Yiluo-pHoton/Electrick_ROV/README.md

# Electrick_ROV
Remotely Opearted Vehicle with Visualized Terrain

This is a quarter-long project for PHYS CS 15C at UCSB. Collaborators include David Wang, Frank Fu, and Yiluo Li.
