Yiluo-pHoton/Electrick_ROV/Final_paper/figure/EIT.png

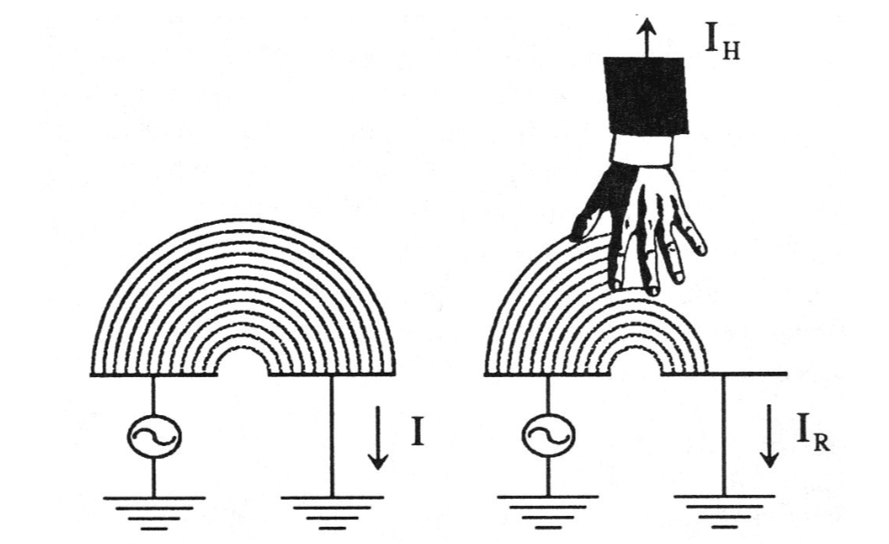
Final_paper/figure/EIT.png
