Yiluo-pHoton/Electrick_ROV/Final_paper/figure/finger1.JPG

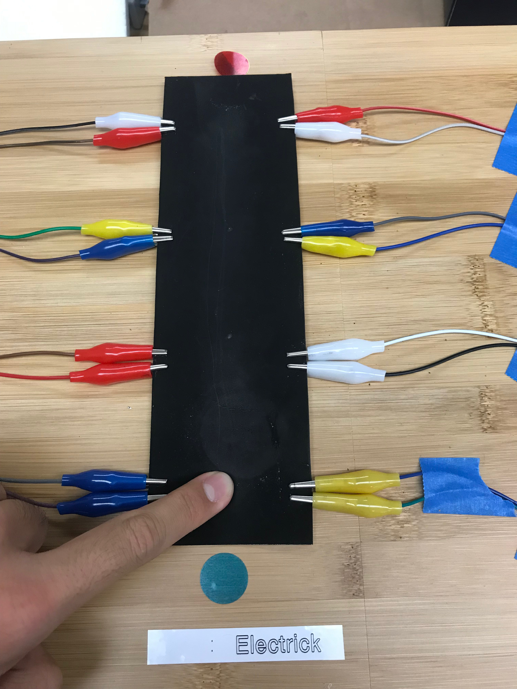
Final_paper/figure/finger1.JPG
