Yiluo-pHoton/Electrick_ROV/Final_paper/figure/finger2.JPG

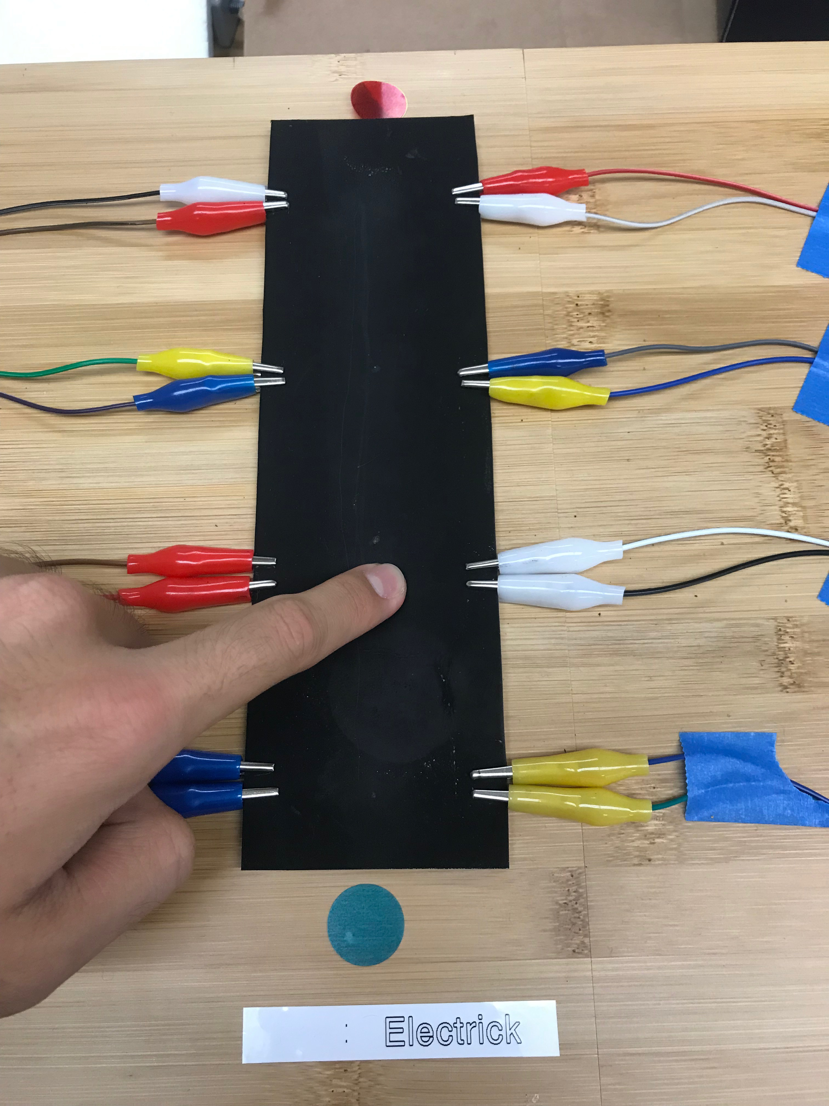
Final_paper/figure/finger2.JPG
