Yiluo-pHoton/Electrick_ROV/Final_paper/figure/finger3.JPG

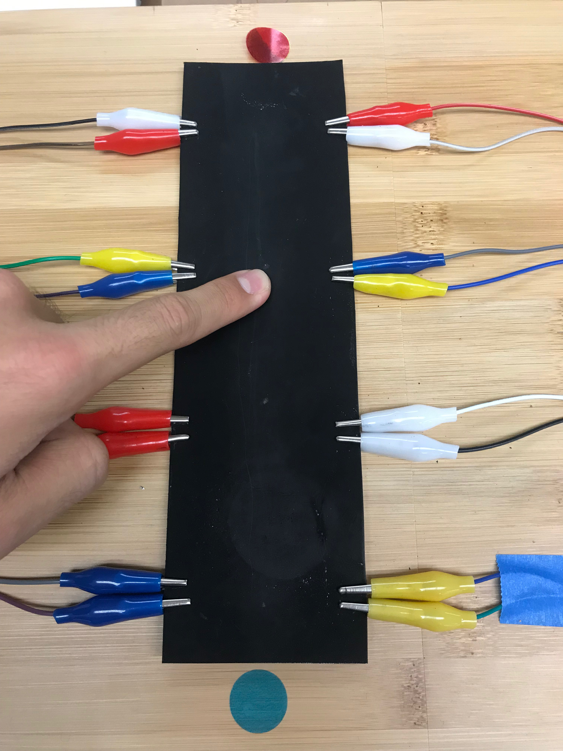
Final_paper/figure/finger3.JPG
