Yiluo-pHoton/Electrick_ROV/Final_paper/figure/finger4.JPG

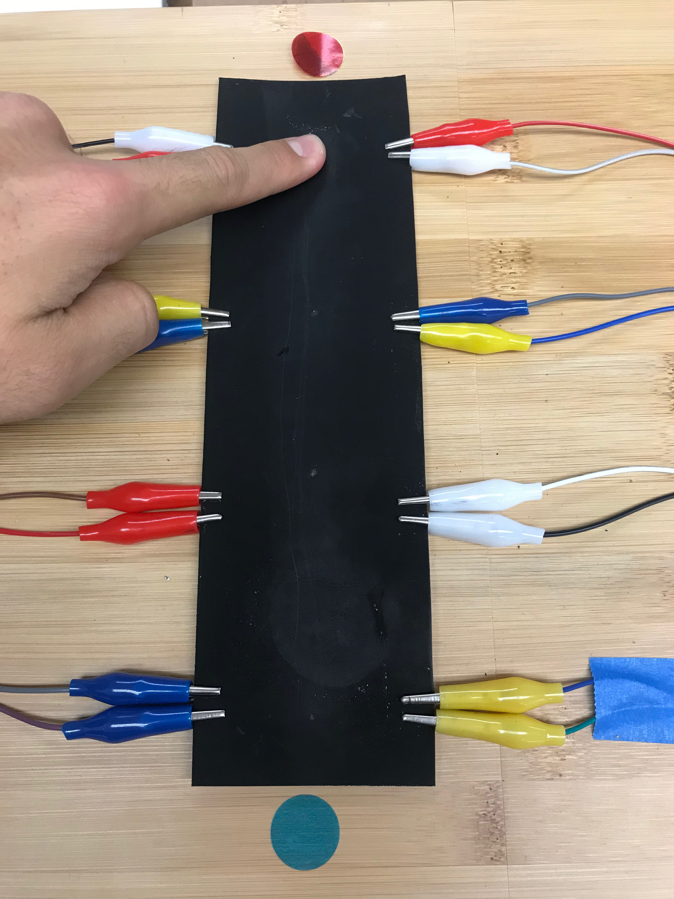
Final_paper/figure/finger4.JPG
