Yiluo-pHoton/Electrick_ROV/Final_paper/figure/point.png

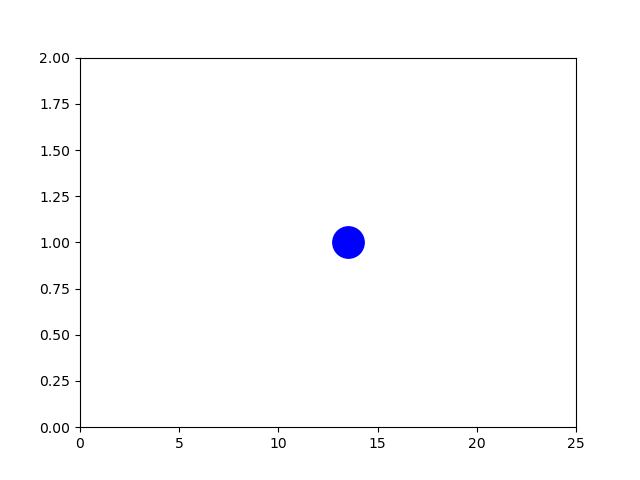
Final_paper/figure/point.png
