Yiluo-pHoton/Electrick_ROV/code/visual/const.py

import numpy as np

POS = np.array([
            [2.5, 1],
            [8, 1],
            [14.5, 1],
            [20.5,1],
            [2.5, 1],
            [8,1],
            [14.5,1],
            [20.5,1],
            [2.5, 1],
            [8,1],
            [14.5,1],
            [20.5,1],
            [2.5, 1],
            [8,1],
            [14.5,1],
            [20.5,1],
            [2.5,1],
            [8,1],
            [14.5,1],
            [20.5,1]])

       #)
a =         [   [7.5, 7.5],
            [22.5, 7.5],
            [22.5, 22.5],
            [7.5, 22.5],
            [15., 7.5],
            [22.5, 15.],
            [15., 22.5],
            [7.5, 15.],
            [5.1, 3.1],
            [10.2, 6.3],
            [19.5, 4.5],
            [23.4, 6.6],
            [6., 9.3],
            [10.9, 13.],
            [18.3, 8.2],
            [27.6, 14.3],
            [3.2, 20.5],
            [10.1, 18.8],
            [16.4, 16.9],
            [23.5, 19.5],
            [3.8, 25.3],
            [13.3, 25.6],
            [17.1, 27.4],
            [26.8, 24.5]
            ]
