Yiluo-pHoton/Electrick_ROV/(commit log)

2019-04-10 added current density map construction part
2019-04-17 added arduino code
2019-04-18 relay testing
2019-04-23 arduino loop for measuring voltages
2019-04-30 create a stub voltage 0V and 5V
2019-05-04 fix conda env issue
    [vis_test.py]
2019-05-04 correct pins, now top two left to right is p1, p2 etc
    [8electro_read.ino, vis_test.py]
2019-05-22 see dot in 4-frames
2019-05-22 voltage differential
2019-05-22 arduino voltage_diff
2019-05-22 voltage diff
2019-06-08 voltage map
